swholmstead/DumpTruck/docs/assembly.md

<h2>Assembly Instructions</h2>
<h3>Trailer</h3>
Add 30 cm of wire with JST-XH connector to N20 55mm 12V lift motor.  Insert motor into swivel mount and firmly press in lift motor lock.
Route wires through retainers towards cab. Insert M4 nut into lift motor shaft and screw onto lift motor.  Attach lift motor to trailer with M2.6 x 6mm screws (qty 2).

Push motor gear onto N20 12V 200rpm motor.  Add 300mm of wire with JST-XH connector. Secure to trailer with motor lock and M2.6 x 6mm screws (qty 2).
Route wires through retainers towards cab.

Press in 6700-2RS bearing at front of trailer.

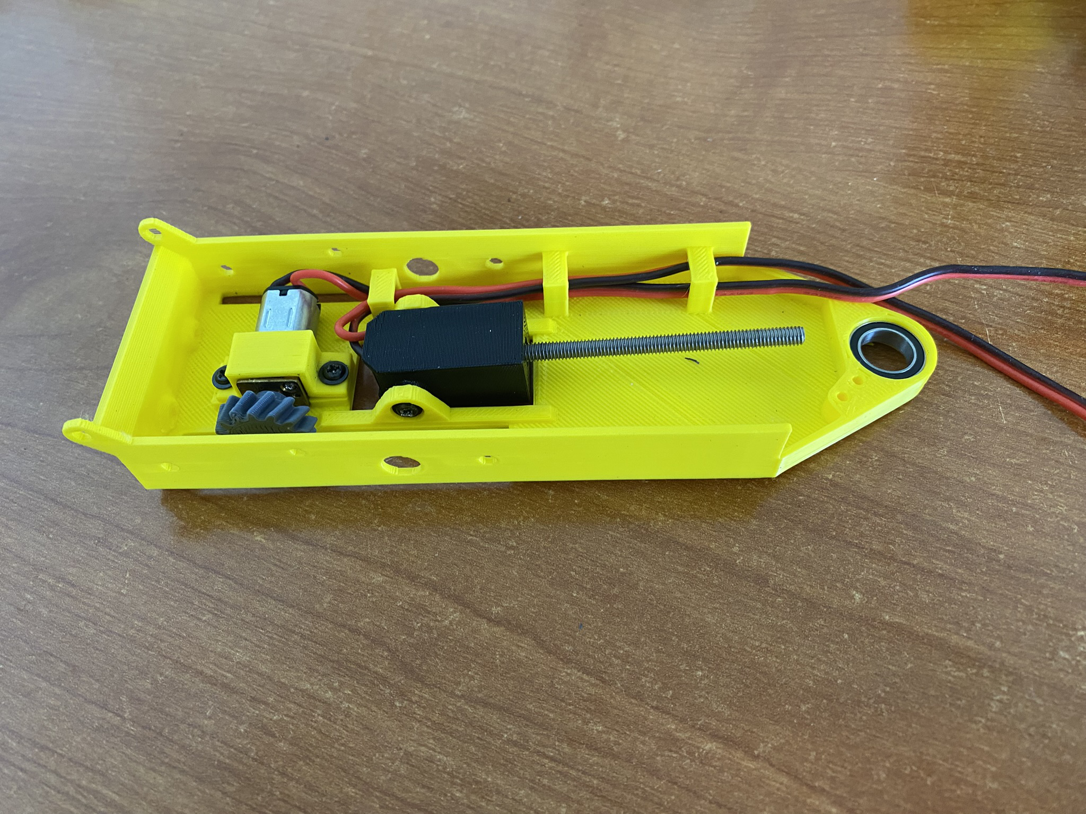
[picture p9: pictures/IMG_3445.JPEG]


Using soldering iron or heat press, insert M4x4x5mm insert nuts (qty 2) into ONE of the trailer axle mounts.  This will be the drive side with gears.
These are where the 2 idler gears are attached.  Insert from the side AWAY from the bearings.

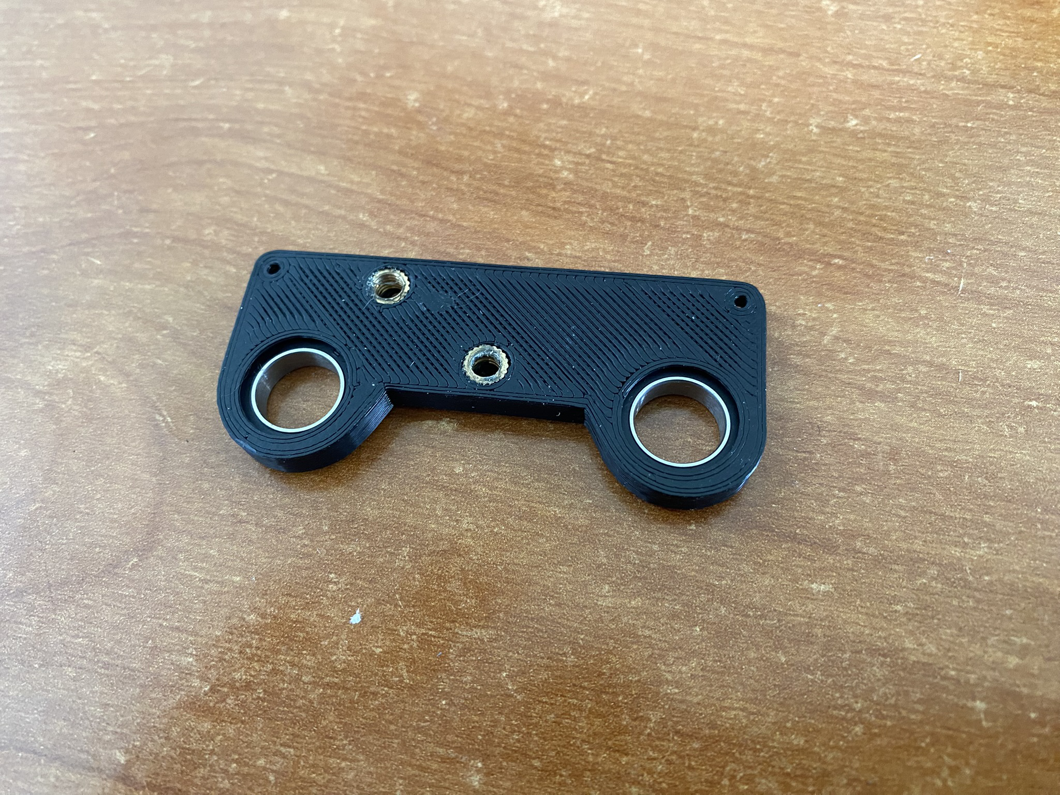
[picture p10: pictures/IMG_3441.JPEG]


Firmly press 6700-2RS bearings into trailer axle mounts.

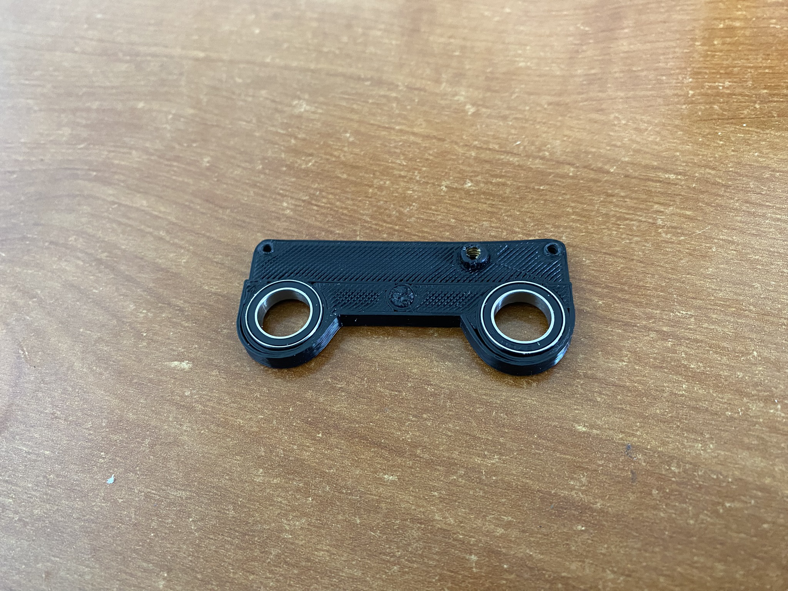
[picture p11: pictures/IMG_3444.JPEG]


Attach the 14L and 14R gears with M4 x 12mm screws (qty 2).
Assemble the drive train by pushing rear axles through the trailer axle mounts with an axle gear and secure axles with M2.6 x 6mm screws.
I recommend using M2.6 x 8mm screws to go through axle gear into rear axle pieces.

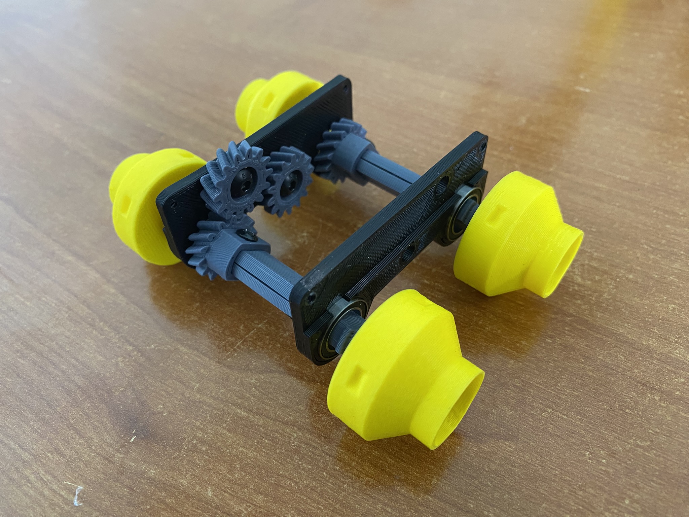
[picture p12: pictures/IMG_3440.JPEG]


Insert drive train into trailer and attach with M2.6 x 6mm screws.

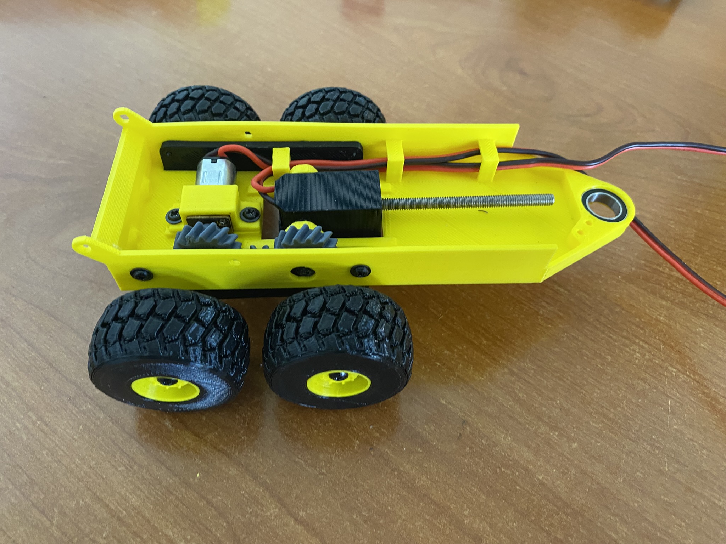
[picture p13: pictures/IMG_3447.JPEG]


<h3>Bed</h3>

Attach bed at rear with M2.6 x 6mm screws.  Attach front of bed with M2.6 x 12mm screw.

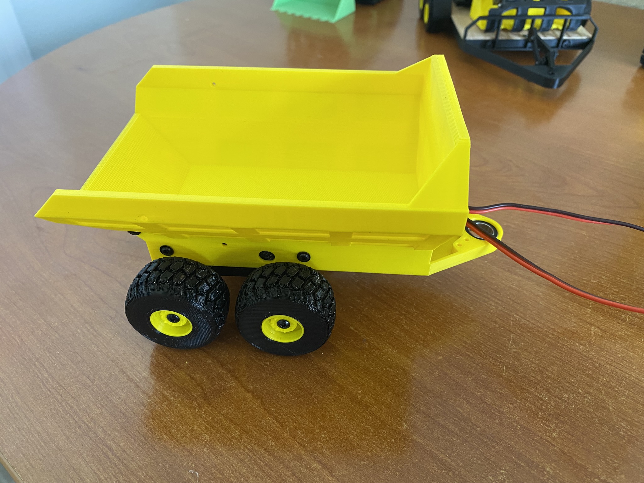
[picture p14: pictures/IMG_3448.JPEG]


<h3>Cab</h3>

Add 10 cm of wire with JST-XH connector to N20 12V 200rpm motor.  Secure to cab with motor lock and M2.6 x 6mm screw.
Attach fenders with M2.6 x 6mm screws.

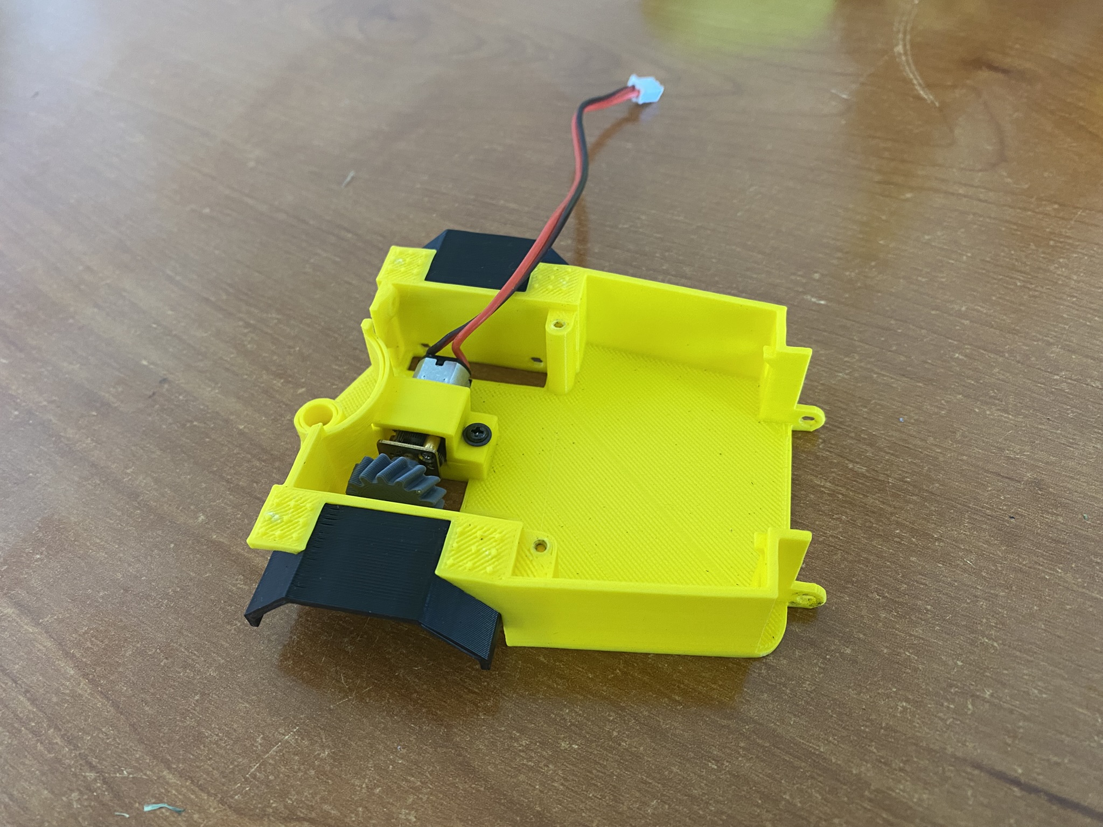
[picture p15: pictures/IMG_3453.JPEG]


Firmly press 6700-2RS bearings into front axle mount.

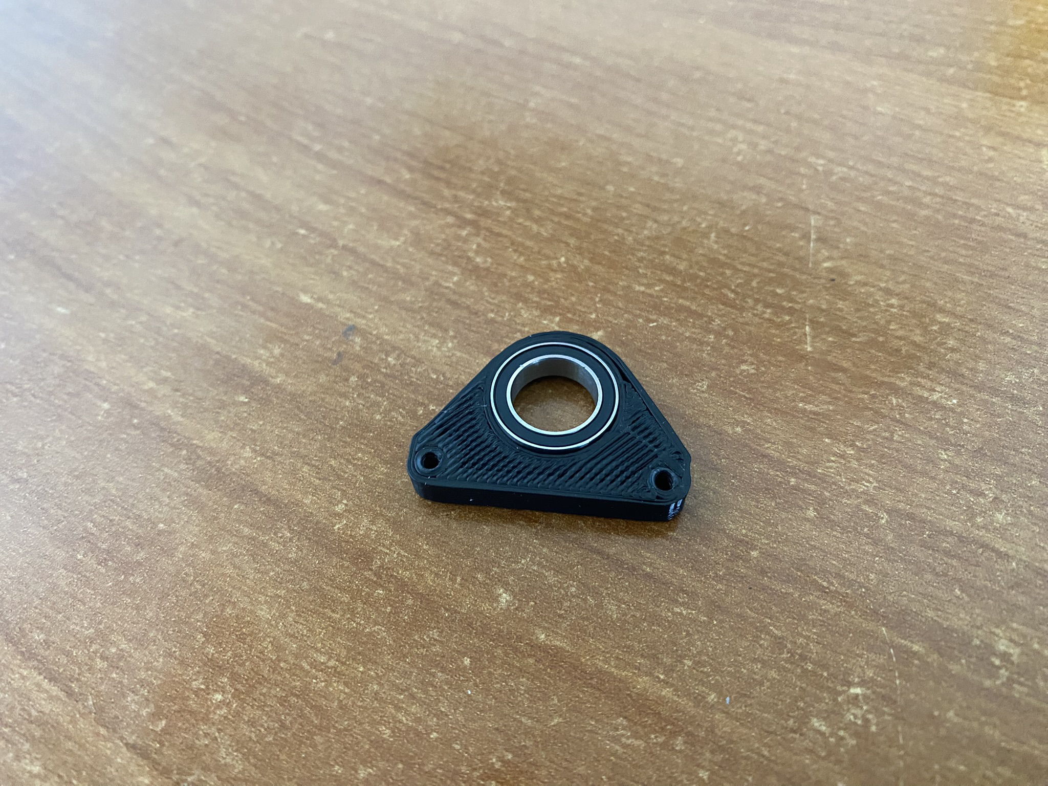
[picture p16: pictures/IMG_3459.JPEG]


Assemble front drive train with axle gear into axle mounts and secure with M2.6 x 6mm screws.  I recommend using M2.6 x 8mm screw through axle gear.

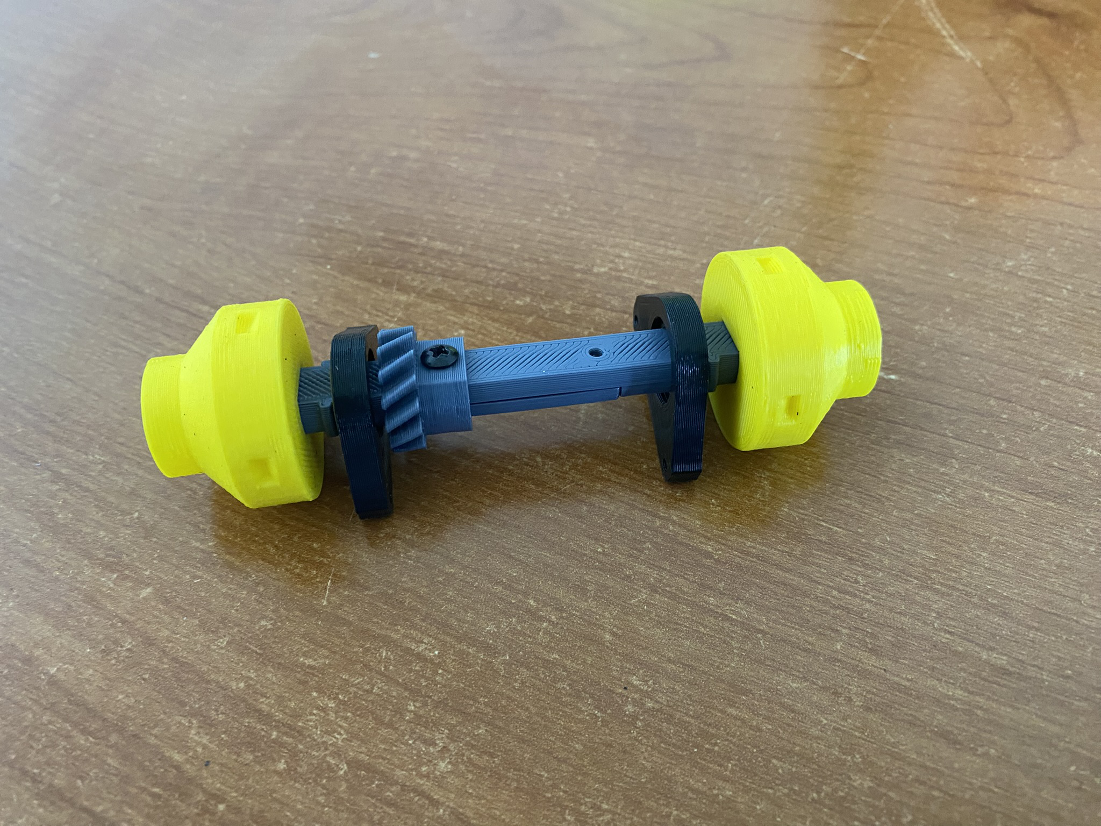
[picture p17: pictures/IMG_3460.JPEG]


Insert drive train into cab and secure with M2.6 x 6mm screws.

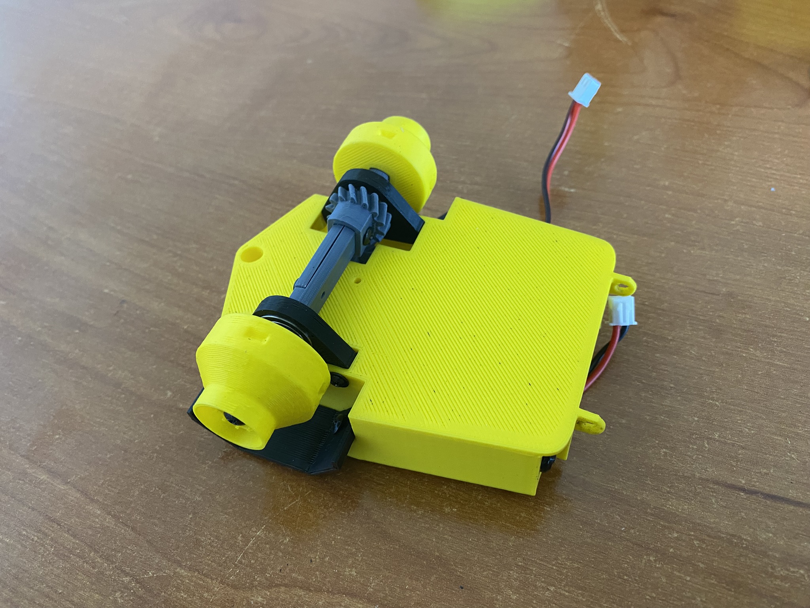
[picture p18: pictures/IMG_3461.JPEG]


Attach led and led holders with 10 cm of wire with JST-XH connector to cab.

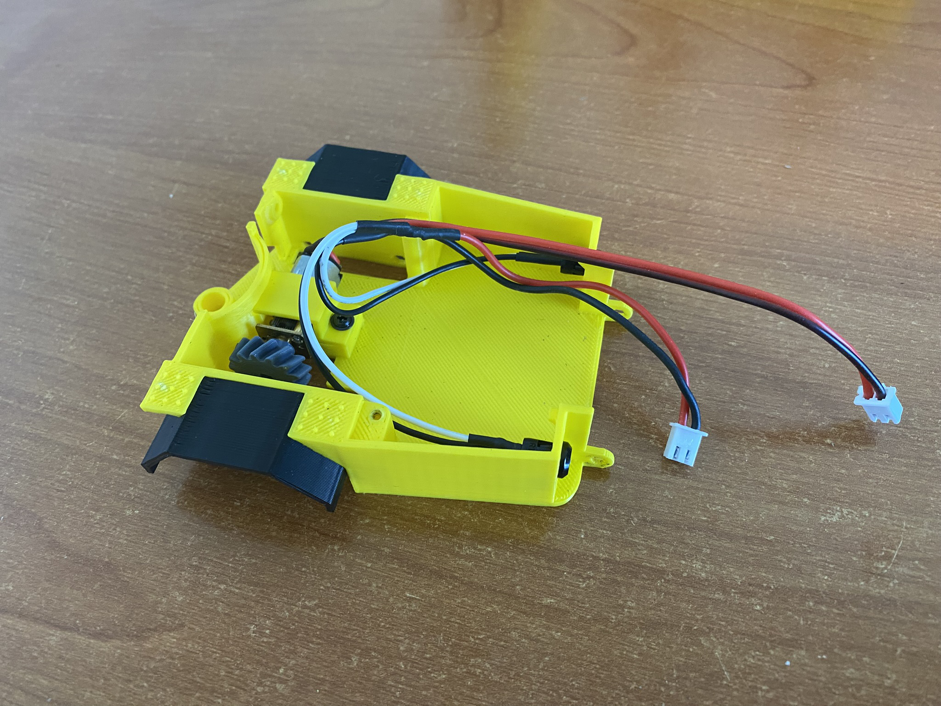
[picture p19: pictures/IMG_3458.JPEG]


Attach cab roof and grill to cab hood with M2.6 x 6mm screws.

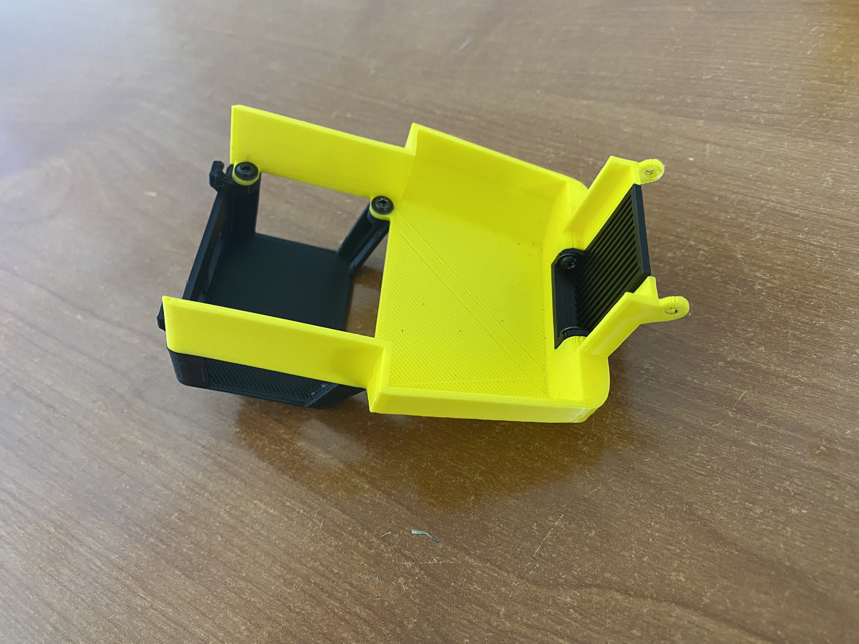
[picture p20: pictures/IMG_3454.JPEG]


Combine cab and cab roof with M2.6 x 6mm screws.

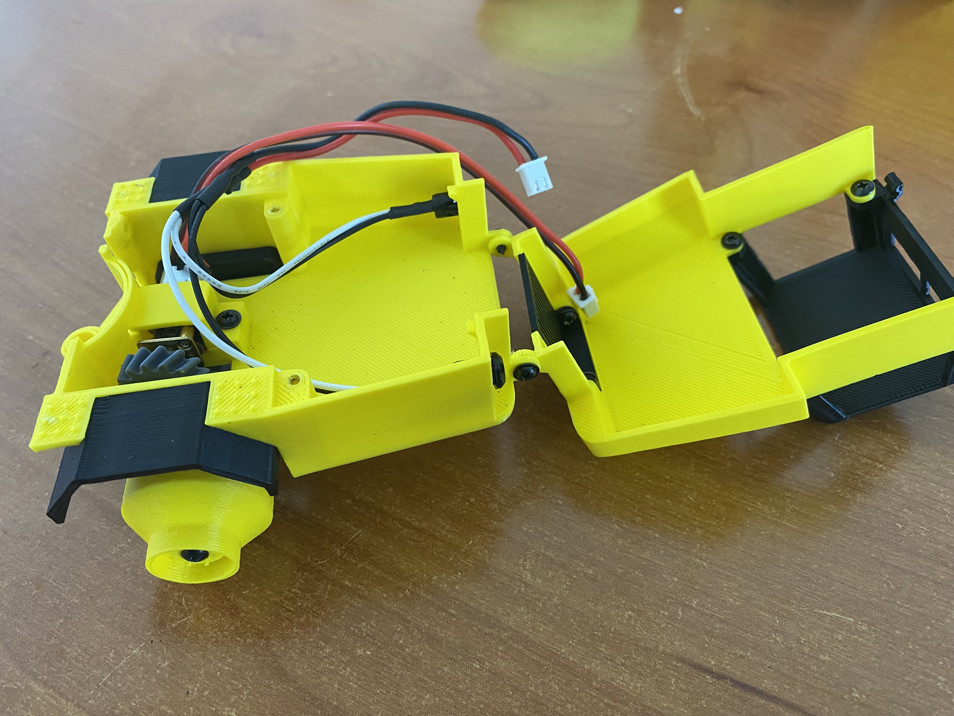
[picture p21: pictures/IMG_3462.JPEG]


Attach servo to cab servo mount with arm at the angle shown in the picture.

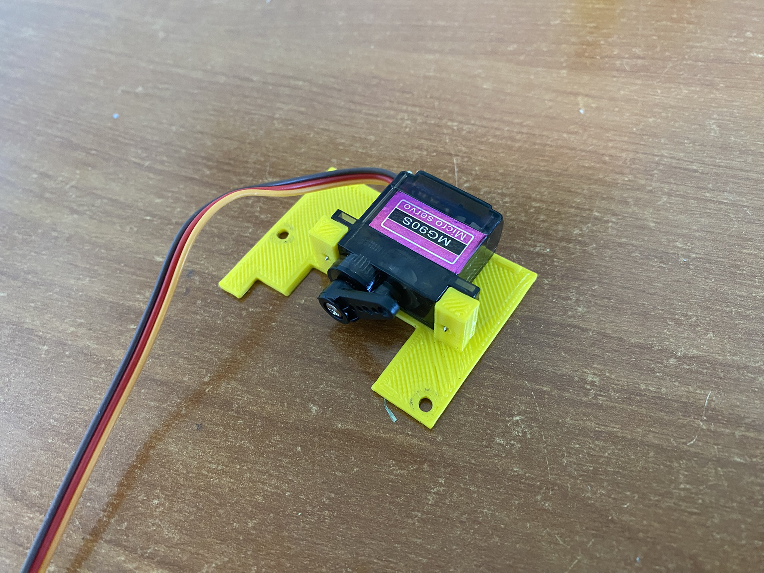
[picture p22: pictures/IMG_3457.JPEG]


Connect trailer with cab using 6700-2RS bearing mount point.

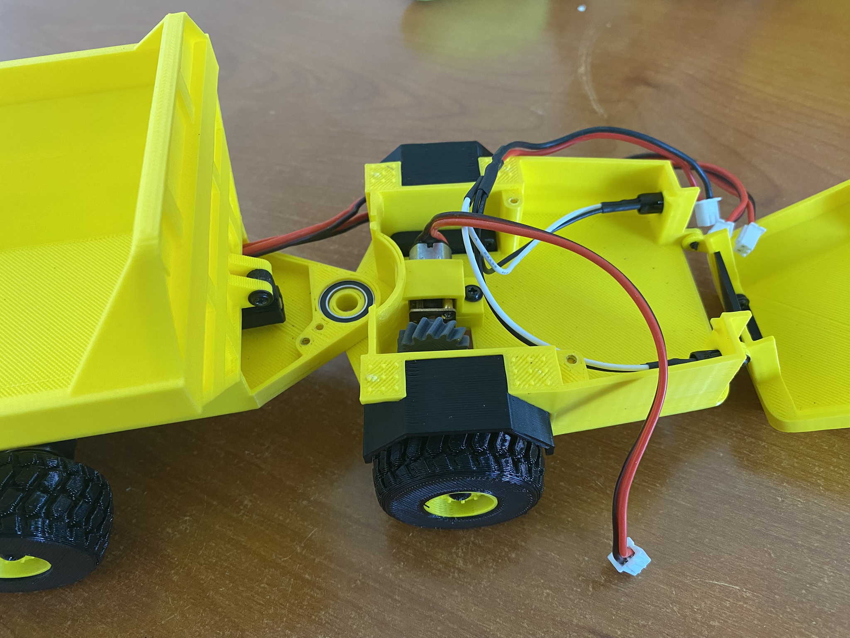
[picture p23: pictures/IMG_3463.JPEG]


Route wires through lower gap in cab and carefully attach servo mount to cab using M2.6 x 6mm screws.  Ensure to leave slack
so that trailer wires do not bind when turning.

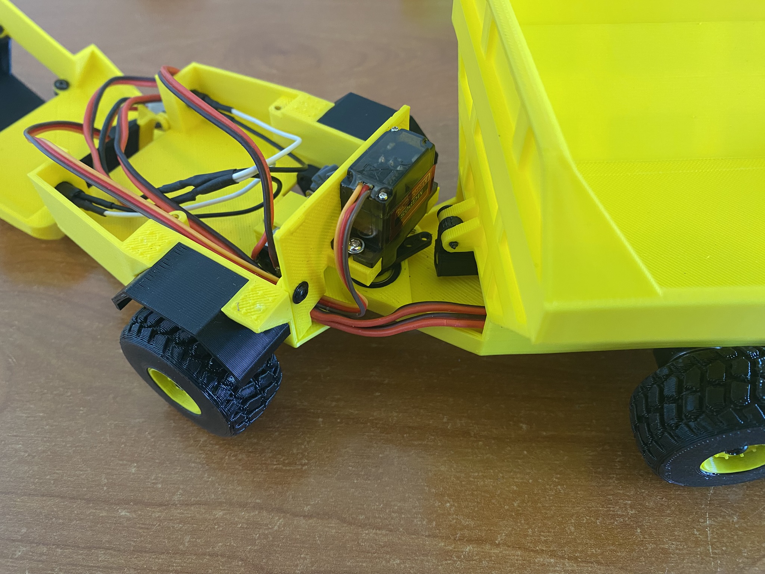
[picture p24: pictures/IMG_3464.JPEG]


Plug in electronics and route wires through front gaps in circuit board.  Secure PCB to cab with M2.6 x 6mm screws.

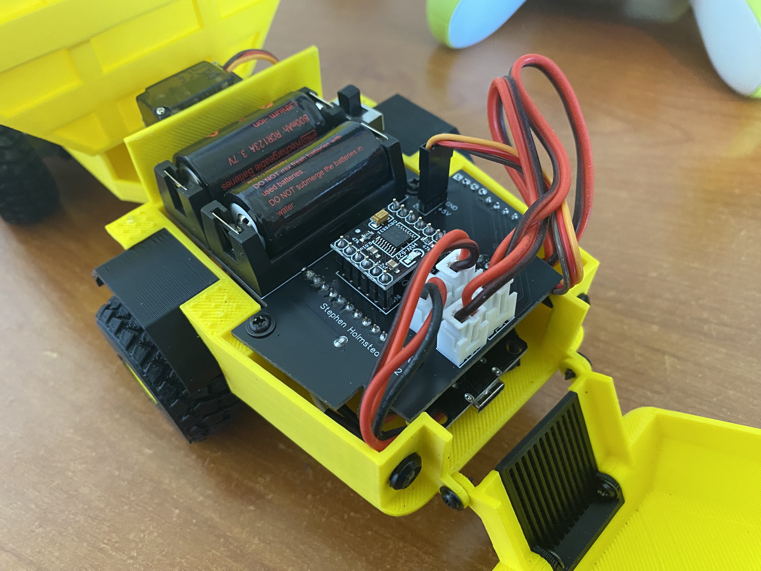
[picture p25: pictures/IMG_3465.JPEG]


<h3>Hitch (optional)</h3>

Attach trailer hitch to trailer with M2.6 x 6mm screws  Attach trailer rod to bed with M2.6 x 12mm screw.

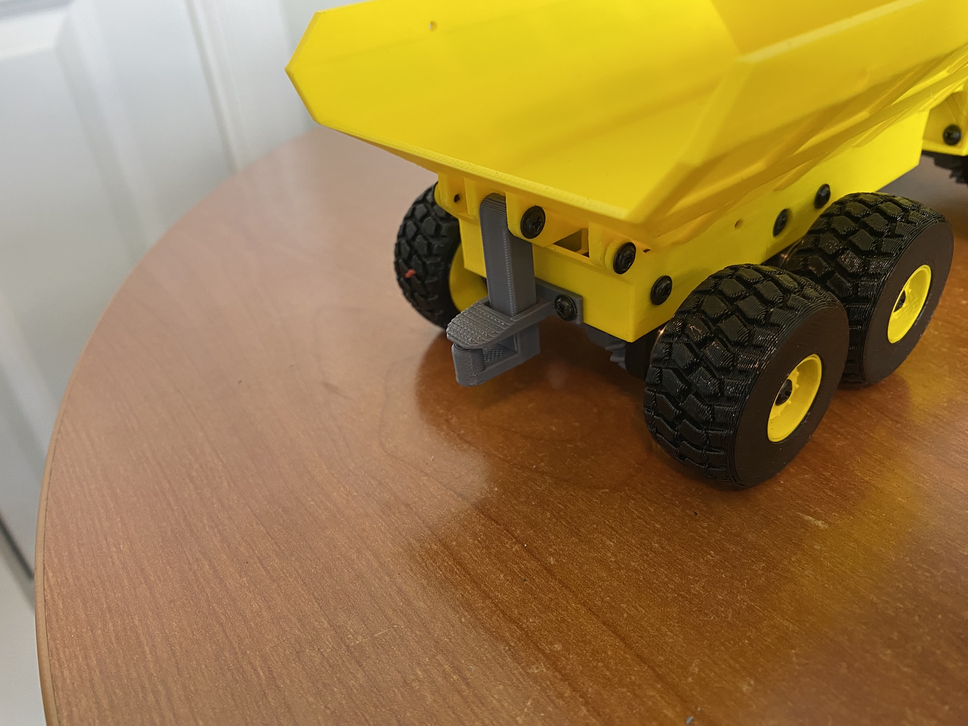
[picture p26: pictures/IMG_3450.JPEG]

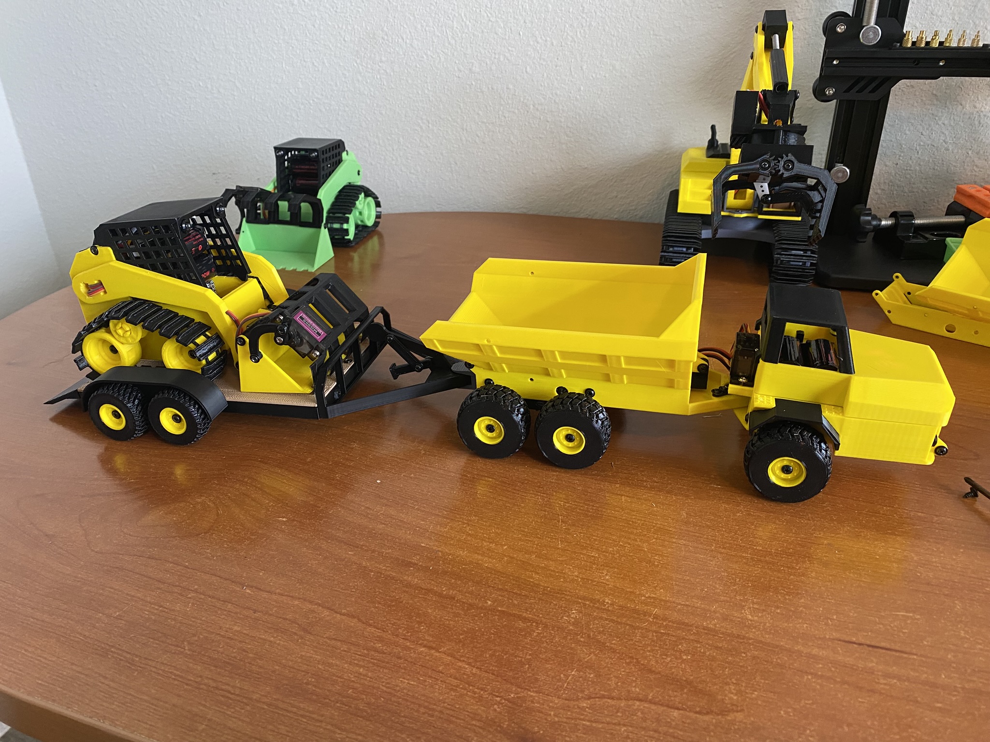
[picture p27: pictures/IMG_3451.JPEG]


<h3>Lift Gate (optional)</h3>

Attach lift gate to bed with M2.6 x 6mm screws.  Attach lift chains from bed to trailer with M2.6 x 6mm screws.
Lift gate will rise automatically when bed is raised.

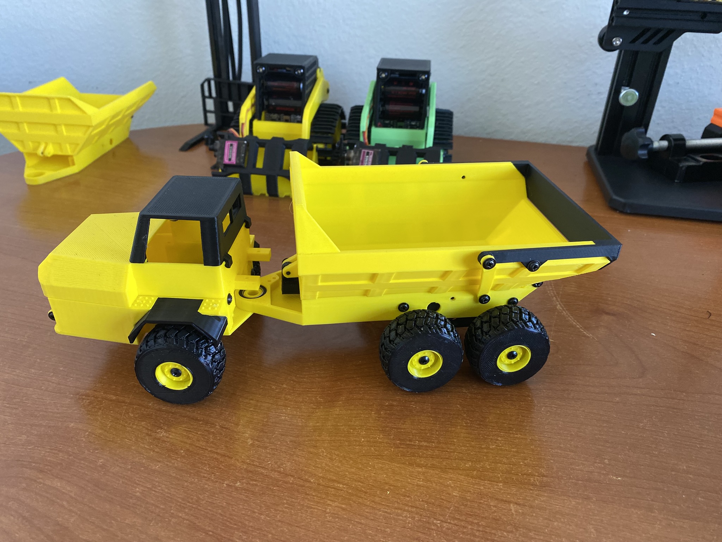
[picture p28: pictures/IMG_3397.JPEG]

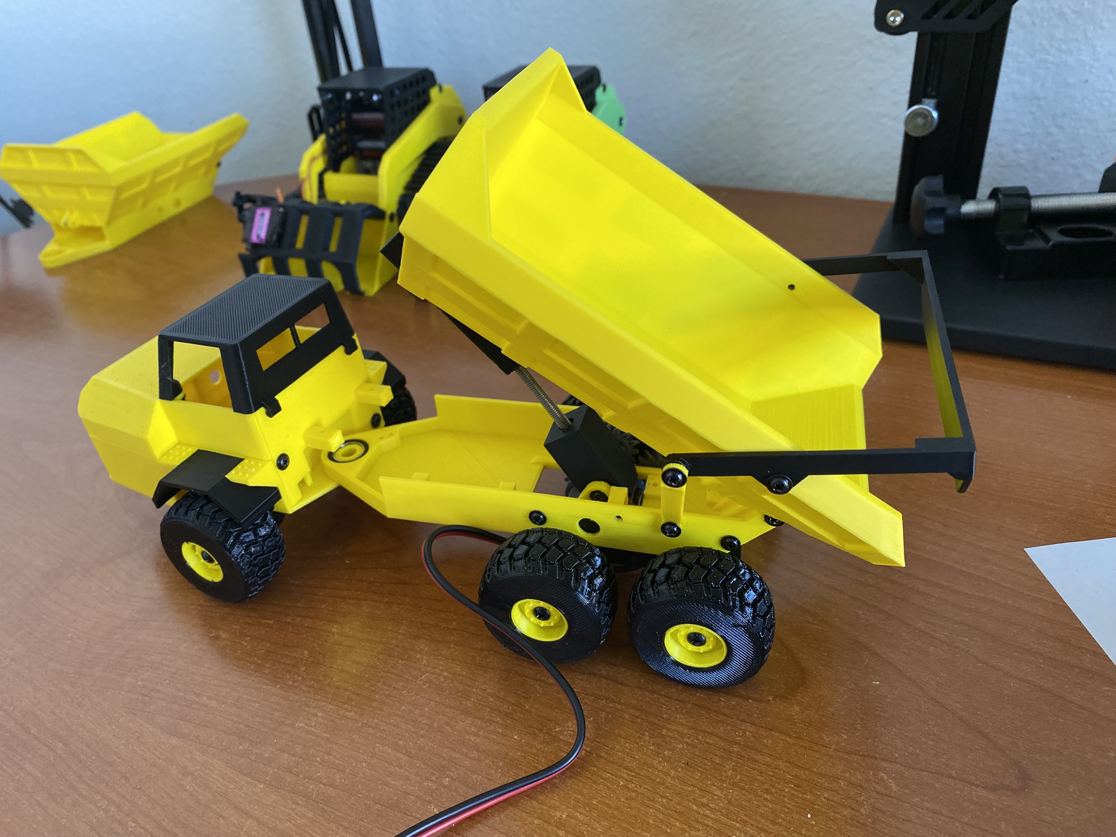
[picture p29: pictures/IMG_3398.JPEG]
