swholmstead/DumpTruck/(commit log)

2025-01-27 Renamed Gerber files
2025-01-28 Added schematic and PCB
2025-01-28 Disallow multiple BT connections
    Prevents multiple controllers from connecting to the same vehicle.
    [DumpTruck_Bluepad.ino]
2025-02-20 Slowed steering turning rate
2025-02-21 Tweaked steering speed
2025-02-24 Started adding assembly instructions
2025-02-27 Create ESP32 Pinout Reference- Which GPIO pins should you use- - Random Nerd Tutorials.url
2025-02-27 Added assembly pictures
2025-02-28 Added more assembly pictures.
2025-03-05 Added low gear
    Pressing button L1 puts throttle in low gear (6:1 speed reduction).
2025-03-10 Added electronics assembly instructions
2025-09-10 Add +5V check
2025-10-29 Updated info on insert nuts
2025-10-29 Insert nut updates
